brokkoli71/Lichen/README.md

# Lichen

Lichen are natural bioindicators for good air quality
([NABU Aichtal](https://www.nabu-aichtal.de/kalenderblatt/februar/flechten/)). This is
an air quality, humidity and temperature sensor in a wooden case. Readings show on a
small OLED on the front, and go to Home Assistant (ESPHome firmware) or are served
over HTTP (Arduino sketch).

<p align="center">
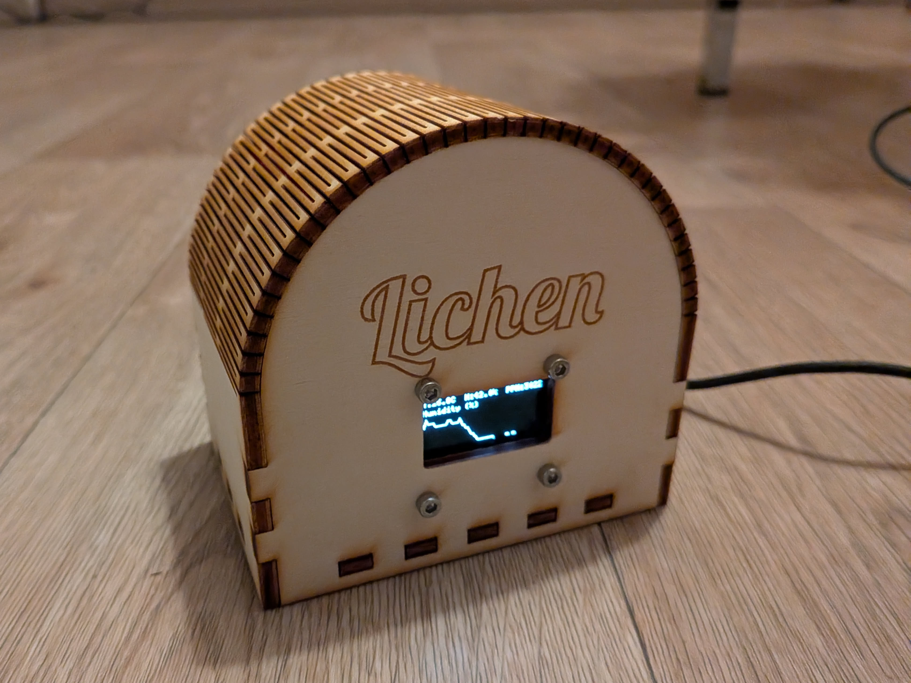
[picture p1: img/lichen-front.jpeg]
Lichen from the front: arched plywood case with the engraved logo and the OLED showing a humidity graph
  
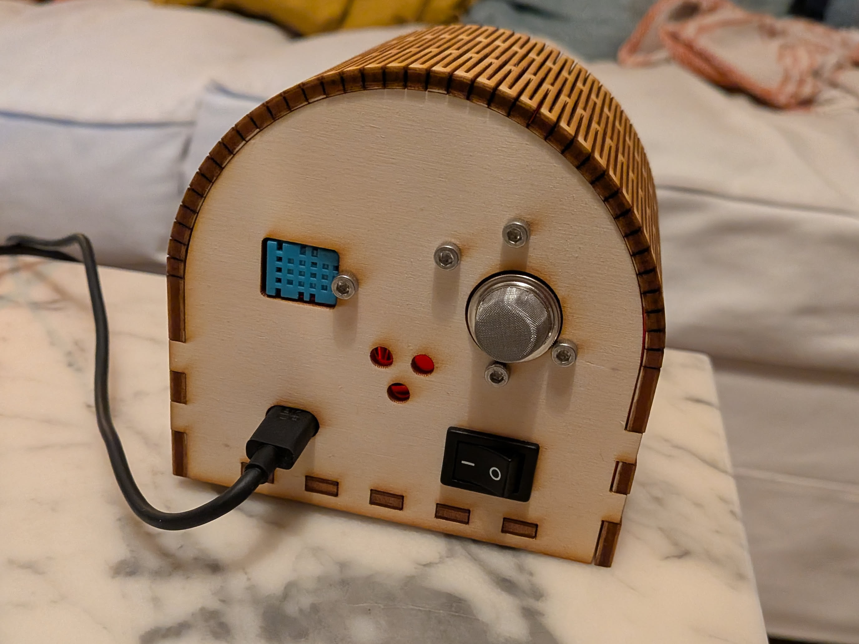
[picture p2: img/lichen-back.jpeg]
Lichen from the back: DHT11 and MQ135 sensors, USB-C cable and rocker switch
  
</p>

An ESP32 reads an **MQ135** air quality sensor and a **DHT11** temperature/humidity
sensor, and drives a 1.3" SH1106 OLED behind an arched plywood shell that bends around a
lattice living hinge. Four lasercut parts, 24 finger joints, one sheet of 4 mm ply.

## Repo layout

```
case/       lasercut enclosure — cut files, calibration sheets, archive
docs/       hardware.md: bill of materials and the case openings
firmware/   esphome/ for Home Assistant; lichen2/ Arduino sketch with an HTTP API;
            archive/ is superseded
img/        photos of the finished unit
```

## Home Assistant (ESPHome)

[`firmware/esphome/`](firmware/esphome/) is an [ESPHome](https://esphome.io) config
for the same wiring. It reports temperature, humidity and air quality to Home Assistant,
which keeps the history, and pulls the outside temperature, today's forecast max and
expected rain back from HA for the display. The OLED shows an overview page; with the
switch on it cycles through that and four graphs. After the first USB flash, updates go
over Wi-Fi.

Air quality is the raw MQ135 reading (higher = worse air), not a concentration; see the
note below. Setup, flashing, adding it to HA and the forecast template sensors are in
[`firmware/esphome/README.md`](firmware/esphome/README.md).

## Arduino sketch and HTTP API

[`firmware/lichen2/`](firmware/lichen2/) is the sketch to build; `firmware/archive/`
holds the earlier version. Wiring, dependencies and the full API are in
[`firmware/README.md`](firmware/README.md).

Wi-Fi credentials go in a gitignored `secrets.h` — copy `firmware/secrets.h.example`
next to the sketch and fill it in. The build fails until you do, on purpose.

One endpoint, on port 80:

```
GET /mq135  ->  {"current_adc", "current_ppm", "current_temperature",
                 "current_humidity", "wifi_state", "queue": [...]}
```

`queue` holds up to 128 samples taken every 5 s, newest first — a little under
11 minutes of history.

> `ppm` is **not** a calibrated concentration. The MQ135 is a general air quality
> sensor that responds to VOCs, ammonia and smoke as much as to CO2, and the firmware
> converts its reading with a plain linear rescale rather than the sensor's real
> response curve. It trends with air quality; it is not a measurement in ppm.
> `current_adc` is the honest number.

## Cutting the case

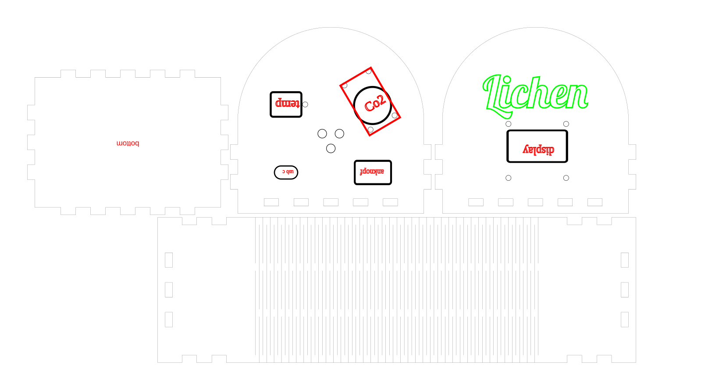
[picture p3: case/preview.png]
Lasercut sheet for the Lichen case


[`case/cut/lichen_sept_9_v4.svg`](case/cut/) is one sheet of 4 mm plywood and gives a
complete case. **Cut black, engrave green, ignore red.**

Kerf compensation is machine-specific. [`case/calibration/`](case/calibration/) has a
test sheet that measures your kerf and board thickness and tells you what to use.
[`case/README.md`](case/README.md) has the detail.

## Licensing

| what | licence |
|---|---|
| Code (`firmware/`, and any code added later) | [MIT](LICENSE) |
| Case design files, documentation and photos (`case/`, `docs/`, `img/`) | [CC BY 4.0](case/LICENSE) |

Both are permissive: use it, change it, build it, sell it — just keep the
attribution. Note that CC BY does not grant trademark rights, so the Lichen name
and logo are not licensed along with the files.

The case was generated with [Boxes.py](https://github.com/florianfesti/boxes)
(GPLv3) and then edited by hand. Boxes.py's own
[FAQ](https://florianfesti.github.io/boxes/html/faq.html) states that "the
resulting drawings do not fall under the GPL license", so these SVGs carry no GPL
obligation. The generator URL and parameters are preserved in each file's header.

The "Lichen" wordmark is set in [Lobster](https://fonts.google.com/specimen/Lobster)
(SIL Open Font License), converted to outlines.
