brokkoli71/Lichen/firmware/README.md

# Firmware

Arduino sketches for the ESP32. Sample the sensors, draw to the OLED, serve the
readings over HTTP.

```
lichen2/lichen2.ino         <- the one to build
archive/lichen/lichen.ino   <- superseded, kept for reference
secrets.h.example           <- template, copy next to the sketch you build
esphome/                    <- ESPHome + Home Assistant variant, see esphome/README.md
```

`lichen2` has a non-blocking loop, a Wi-Fi state machine, a debounced switch and
scrolling graphs; the archived one is a blocking loop with a plain text readout. Both
use the same wiring and expose the same endpoint.

Each sketch sits in a folder named after it because the Arduino IDE requires that, and
concatenates every `.ino` in a folder into one compilation unit.

## Wiring

| function | GPIO | notes |
|---|---|---|
| MQ135 analog out | **34** | ADC1, input-only pin. 12-bit, `ADC_11db` attenuation |
| DHT11 data | **27** | |
| OLED SDA | **23** | I2C |
| OLED SCL | **18** | I2C |
| Power switch | **25** | `INPUT_PULLUP` — closed to GND reads LOW = ON |

Any classic ESP32 board works; two different ones have been used. The pin numbers
assume classic ESP32 numbering (GPIO34 is input-only there), so an ESP32-C3/S2/S3
would need remapping.

## Wi-Fi

Credentials live in `secrets.h`, which is **gitignored**. It has to sit next to the
sketch you're building, because `#include "secrets.h"` resolves relative to the `.ino`:

```sh
cp secrets.h.example lichen2/secrets.h
```

then fill in your network:

```c
const char* ssid     = "your ssid";
const char* password = "your password";
```

The build fails with a missing-header error until you've created it. Never put real
credentials in a `.ino` — this repo is public.

## HTTP API

One endpoint, on port 80:

```
GET /mq135  ->  application/json
```

```jsonc
{
  "current_adc":          2047,     // raw 12-bit ADC from the MQ135
  "current_ppm":          2700,     // see the caveat below
  "current_temperature":  21.4,     // °C
  "current_humidity":     48.0,     // % RH
  "wifi_state":           2,        // lichen2.ino only
  "queue": [                        // newest first
    { "adc": 2047, "ppm": 2700, "temperature": 21.4, "humidity": 48.0 }
  ]
}
```

`wifi_state`: `0` off, `1` connecting, `2` connected, `3` failed.

`queue` holds up to 128 samples taken every 5 s — a little under 11 minutes of history,
and only slots containing real data are returned.

> **`ppm` is not a calibrated concentration.** The conversion is
> `map(adc, 0, 4095, 400, 5000)` — a linear rescale of the raw ADC into the range
> 400–5000. It ignores the MQ135's logarithmic Rs/R0 response, is not calibrated against
> a reference, and applies no temperature or humidity compensation. Treat it as a
> relabelled raw reading that trends with air quality, not as ppm. `current_adc` is the
> honest number.

## Dependencies

Arduino IDE / arduino-cli with the ESP32 core, plus:

- [ESPAsyncWebServer](https://github.com/me-no-dev/ESPAsyncWebServer) (and AsyncTCP)
- [DHT sensor library](https://github.com/adafruit/DHT-sensor-library) (and Adafruit Unified Sensor)
- [U8g2](https://github.com/olikraus/u8g2)

`WiFi.h` and `Wire.h` come with the ESP32 core.

## Behaviour

With the switch off the display shows `Switch OFF`, Wi-Fi is disconnected and nothing is
sampled. With it on, sensors are read every 5 s and the display cycles through three
graphs — temperature, PPM, humidity — 5 s each, autoscaled to what's on screen. A failed
DHT read carries the previous value forward rather than pushing a NaN, so the three
history queues stay aligned.

Wi-Fi connects only while the switch is on, with a 15 s timeout, and a status icon sits
bottom-right: dot only = radio off, animating arcs = connecting, full arcs = connected,
arcs with a slash = failed. A failed attempt retries when the switch is cycled.
