brokkoli71/Lichen/(commit log)

2026-09-10 Add lasercut case, hardware docs and licensing
    Lichen is an ESP32 sensor unit measuring CO2, humidity and temperature,
    showing readings on a 1.3" SH1106 OLED and serving them over HTTP.
    Case (case/):
    - cut/lichen_sept_9_v4.svg complete case, burn 0.08, bottom-plate
    tabs deliberately uncompensated
    - cut/lichen_sept_9_v3_front_panel.svg single panel at burn 0.09, to
    replace one panel against an existing shell
    - calibration/ fit-test sheets that measure kerf and
    board thickness and yield a burn value
    - archive/ superseded revisions
    Kerf compensation is ap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
2026-09-13 Document firmware; correct "CO2" to air quality
    The firmware landed, so the blanks in docs/hardware.md are filled from the
    source rather than guessed:
    - MQ135 analog air quality sensor on GPIO34
    - DHT11 temperature/humidity on GPIO27
    - SH1106 OLED on I2C, SDA 23 / SCL 18
    - latching power switch on GPIO25 (INPUT_PULLUP, active low)
    This confirms the earlier guess that the separate Co2 and temp openings in the
    case meant two sensors: MQ135 plus DHT11, the DHT11 covering both temperature
    and humidity. The measured openings corroborate the parts — 16.50 x 13.20 for a
    15.5 x 12 DHT11 body, and 19.52 x 12.54 is the panel cutout for a KCD1-101
    rocker, which matches the firmware treating the swi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
    [lichen.ino]
2026-09-13 Move Wi-Fi credentials to a gitignored secrets.h
    Both sketches now #include "secrets.h" instead of carrying the SSID and
    password as literals. secrets.h is gitignored; secrets.h.example is committed
    as the template. The build fails with a missing header until you create it,
    which is the point -- the previous layout made committing a real password the
    path of least resistance, and that is how one ended up in commit 6fa0bdf.
    Also:
    - drop the three 4.74 mm back-panel holes from the docs; they are airflow and
    design, not a mounting feature
    - replace the "living hinge unverified" caveat with what it actually is and the
    fact that it has been cut and bent successfully
    - note in firmware/README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
    [lichen.ino, lichen2.ino]
2026-09-13 Split the sketches into lichen2/ and archive/
    firmware/lichen2/lichen2.ino the one to build
    firmware/archive/lichen/lichen.ino superseded
    archive/ rather than deprecated/ to match the convention case/archive/ already
    sets in this repo. The current sketch sits at the top of firmware/, so "the one
    not in archive/" is the one you want.
    Each sketch needs its own folder named after it: the Arduino IDE requires that,
    and it concatenates every .ino in a folder into one compilation unit. Both
    sketches sitting flat in firmware/ meant neither could be opened or built --
    duplicate setup() and loop().
    secrets.h now has to sit beside the .ino, since #include "secrets.h" resolves
    rela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
    [lichen.ino, lichen2.ino]
2026-09-13 Refresh the root README now the firmware has landed
    The Status table still said the firmware was not in the repo and the API was
    undocumented, the layout block said "(pending)", and the BOM was marked as
    incomplete. All three are done.
    Adds a Firmware and API section: which sketch to build, the secrets.h step, the
    endpoint and its response shape, and the caveat that ppm is a linear rescale of
    the raw ADC rather than a calibrated concentration.
    Also names the two sensors in the intro, and stops calling the red back-panel
    marker a "CO2 board footprint".
    Claude-Session: https://claude.ai/code/session_01DeCBr5T6dS6be5mDWJTN5a
2026-09-13 One active cut file; trim the docs of changelog
    lichen_sept_9_v3_front_panel.svg moves to archive/ -- cut/ now holds only
    lichen_sept_9_v4.svg, so there is exactly one thing to cut and no "these two are
    calibrated differently" caveat to explain.
    Colour convention stated properly everywhere: cut black, engrave green, ignore
    red. Green is only the logo; red is placement markers and working labels. That
    replaces the warning box about the red rectangle putting a hole through the
    panel -- "ignore red" covers it in two words.
    Removes the root README Status table and the case README "Before you press go"
    section, and cuts the accumulated history from the rest: the two-file
    comparison, the failed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
2026-09-13 Record the calibration outcome alongside the fit test
    The coupon flatters a tight setting: two tabs pushed together by hand feel
    firmer than the same fit does across 24 joints going home at once. Here it
    picked 0.1, with 0.075 reading as sloppy; assembled, 0.1 cracked the ply and the
    case settled a step looser at 0.08, with the bottom plate at 0.00.
    Written as a worked example next to the fit test rather than as history, so
    whoever runs the sweep next knows to consider the value below the one it picks.
    Same caveat added to case/CLAUDE.md so the test doesn't get re-run and taken at
    face value.
    Claude-Session: https://claude.ai/code/sessi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
2026-10-04 Add an ESPHome variant of the firmware for Home Assistant
    firmware/esphome/lichen.yaml targets the same wiring as lichen2 but reports
    temperature, humidity and air quality to Home Assistant over the native API
    instead of serving /mq135; HA keeps the history, so the on-device queue goes.
    Air quality is the raw ADC count with no unit -- no fake ppm.
    The OLED pulls the outside temperature and today's forecast max/min back from
    HA. The switch on GPIO25 now picks the view: open (as it is while unsoldered)
    holds the overview page, closed cycles through it and four autoscaled graphs.
    Credentials and the API key live in secrets.yaml, gitignored by the
    .gitignore ESPHome generates. The README cover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
2026-10-05 Show today's rain on the OLED instead of the forecast minimum
    The overview's outside column now reads the expected max and today's
    precipitation: "no rain" under 0.1 mm, otherwise the amount. The HA template
    in the README swaps its min sensor for forecast_today_precipitation to match.
    Met.no's daily forecast has an amount but no probability, so it's the amount.
    [lichen.yaml]
2026-10-05 Add photos and an ESPHome section to the README
    Front and back photos of the finished unit open the README, and the lasercut
    sheet preview moves down to "Cutting the case" where it belongs. The photos are
    renamed from the phone's PXL_ names and carry no EXIF beyond a colour profile.
    New "Home Assistant (ESPHome)" section points at firmware/esphome/; the intro
    and repo layout now name both firmwares, and the old "Firmware and API" section
    becomes "Arduino sketch and HTTP API".
